AlePA8/Manipulador/(commit log)

2026-11-06 Modificacion de readme y se agrega el documento del laboratorio
2026-11-09 Actualizacion de parametros de medidas, asi como actualizacion de gui por limitacion de BLYNK.
